WIPACrepo/wuBase-hardware/README.md

# wuBase-hardware
Hardware design files for wuBase photosensor control and readout board developed for IceCube Neutrino Observatory
