WIPACrepo/wuBase-hardware/wuBaseV1.4/wuBaseV1.4PH/wuBaseV1.4PH-3d-view3.png

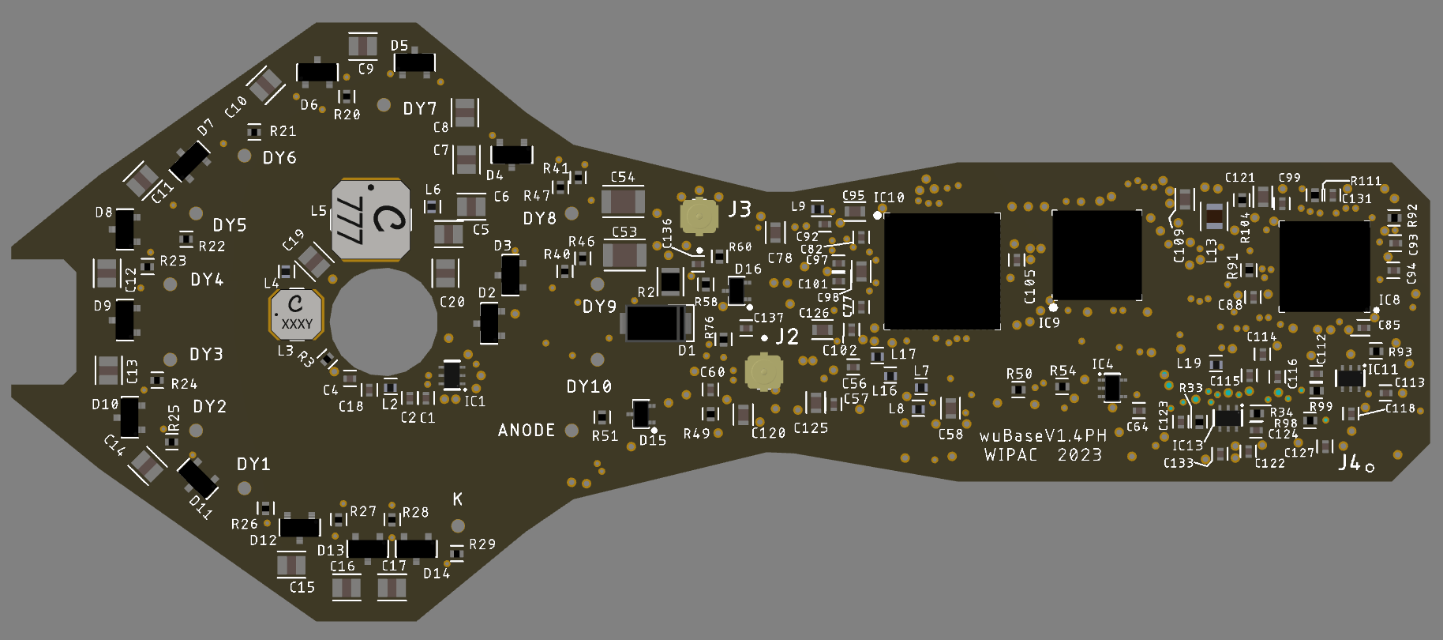
wuBaseV1.4/wuBaseV1.4PH/wuBaseV1.4PH-3d-view3.png
