WIPACrepo/wuBase-hardware/wuBaseV1.4/wuBaseV1.4PH/wuBaseV1.4PH-bom.xlsx

Qty | Value | Package | Parts | Description | MFG | MPN | POPULATE
1 | 0 | R0402 | R108 | Resistor |  | RC0402JR-070RL | 1
4 | 0.01uF | C0402 | C35, C51, C59, C67 | Capacitor |  | CGA2B2X5R1E103K050BA | 1
45 | 0.1uF | C0402 | C2, C3, C4, C34, C50, C56, C60, C61, C64, C69, C71, C73, C85, C87, C88, C90, C91, C92, C93, C94, C96, C97, C99, C100, C101, C102, C103, C104, C105, C106, C107, C108, C110, C114, C115, C116, C118, C122, C127, C129, C131, C132, C133, C136, C137 | Capacitor |  | GCM155R71C104KA55D | 1
2 | 1 | R0402 | R1, R101 | Resistor |  | AC0402FR-071RL | 1
2 | 1.1M | R0402 | R16, R35 | Resistor |  | AC0402FR-071M1L | 1
2 | 1.2K | R0402 | R52, R77 | Resistor |  | AC0402FR-071K2L | 1
4 | 1.8K | R0402 | R67, R71, R81, R86 | Resistor |  | AC0402FR-071K8L | 1
2 | 100 | R0402 | R91, R94 | Resistor |  | AC0402FR-07100RL | 1
5 | 10000pF/500V | C1206 | C49, C52, C53, C54, C55 | Capacitor |  | CGA5L4NP02J103J160AA | 1
1 | 10000uH/LPS6235 | LPS6235 | L5 | Inductor |  | LPS6235-106MRC | 1
8 | 1000pF | C0402 | C1, C57, C62, C70, C72, C74, C86, C89 | Capacitor |  | GCM155R71H102KA37D | 1
1 | 1000uH/LPS4040 | LPS4040 | L3 | Inductor |  | LPS4040-105MRC | 1
4 | 100K | R0402 | R47, R104, R110, R111 | Resistor |  | AC0402FR-07100KL | 1
5 | 100pF | C0402 | C18, C112, C113, C123, C124 | Capacitor |  | C0402C101J3GACAUTO | 1
1 | 10K | R0402 | R95 | Resistor |  | AC0402FR-0710KL | 1
2 | 10M | R0402 | R30, R36 | Resistor |  | AC0402FR-0710ML | 1
1 | 10uF/6.3V | C0805 | C119 | Capacitor |  | C0805C106K8PACTU | 1
1 | 11pF | C0402 | C82 | Capacitor |  | GCM1555C1H110FA16D | 1
8 | 1K | R0402 | R42, R49, R56, R57, R65, R76, R90, R92 | Resistor |  | AC0402FR-071KL | 1
1 | 1M/150V | R0805 | R2 | Resistor |  | AC0805FR-071ML | 1
5 | 1uF | C0603 | C58, C66, C78, C84, C109 | Capacitor |  | LMK107B7105KAHT | 1
2 | 2.2K | R0402 | R80, R89 | Resistor |  | AC0402FR-072K2L | 1
6 | 2.2uF | C0603 | C95, C98, C117, C120, C125, C126 | Capacitor |  | CGA3E1X7R0J225K080AC | 1
2 | 2.4K | R0402 | R83, R87 | Resistor |  | AC0402FR-072K4L | 1
1 | 2.7K | R0402 | R72 | Resistor |  | AC0402FR-072K7L | 1
2 | 200 | R0402 | R55, R59 | Resistor |  | AC0402FR-07200RL | 1
12 | 200M/200V | R1206 | R4, R5, R6, R7, R8, R9, R10, R11, R12, R13, R14, R15 | Resistor |  | CRCW1206200MJPEAHR | 1
2 | 20K | R0402 | R64, R93 | Resistor |  | AC0402FR-0720KL | 1
1 | 20pF | C0402 | C65 | Capacitor |  | GCM1555C1H200JA16D | 1
1 | 22 | R0402 | R53 | Resistor |  | AC0402FR-0722RL | 1
4 | 220 | R0402 | R70, R74, R79, R85 | Resistor |  | AC0402FR-07220RL | 1
39 | 2200pF/250V | C0805 | C5, C6, C7, C8, C9, C10, C11, C12, C13, C14, C15, C16, C17, C21, C22, C23, C24, C25, C26, C27, C28, C29, C30, C31, C32, C33, C36, C37, C38, C39, C40, C41, C42, C43, C44, C45, C46, C47, C48 | Capacitor |  | C0805C222JAGACAUTO | 1
1 | 220pF/100V/5% | C0805 | C20 | Capacitor |  | C0805C221J1GACAUTO | 1
2 | 240 | R0402 | R78, R84 | Resistor |  | AC0402FR-07240RL | 1
4 | 27 | R0402 | R33, R34, R98, R99 | Resistor |  | AC0402FR-0727RL | 1
1 | 270 | R0402 | R54 | Resistor |  | AC0402FR-07270RL | 1
1 | 270K | R0402 | R62 | Resistor |  | AC0402FR-07270KL | 1
2 | 330 | R0402 | R69, R73 | Resistor |  | AC0402FR-07330RL | 1
1 | 33pF | C0402 | C134 | Capacitor |  | GCM1555C1H330FA16D | 1
1 | 3900pF/50V | C0805 | C19 | Capacitor |  | CGA4C2C0G1H392J060AA | 1
17 | 390K | R0402 | R3, R17, R18, R19, R20, R21, R22, R23, R24, R25, R26, R27, R28, R29, R39, R40, R41 | Resistor |  | AC0402FR-07390KL | 1
3 | 3pF | C0402 | C75, C80, C135 | Capacitor |  | GCM1555C1H3R0BA16D | 1
4 | 4.7uF | C0603 | C111, C121, C128, C130 | Capacitor |  | JMK107BJ475KAHT | 1
1 | 430 | R0402 | R75 | Resistor |  | AC0402FR-07430RL | 1
1 | 47K | R0402 | R51 | Resistor |  | AC0402FR-0747KL | 1
4 | 47M/150V | R0805 | R31, R32, R37, R38 | Resistor |  | RC0805JR-0747ML | 1
3 | 49.9 | R0402 | R45, R46, R48 | Resistor |  | AC0402FR-0749R9L | 1
2 | 4pF | C0402 | C79, C83 | Capacitor |  | GCM1555C1H4R0BA16D | 1
1 | 510 | R0402 | R50 | Resistor |  | AC0402FR-07510RL | 1
1 | 56 | R0402 | R60 | Resistor |  | AC0402FR-0756RL | 1
2 | 7.5pF | C0402 | C76, C77 | Capacitor |  | GCQ1555C1H7R5BB01D | 1
2 | 74AUP2G3404GW | SC70-6L | IC11, IC13 | Buffer plus inverter |  | 74AUP2G3404GW,125 | 1
1 | 74LVC1T45DCK | SC70-6L | IC1 | Level Translator |  | 74LVC1T45GW-Q100H | 1
1 | 750 | R0402 | R68 | Resistor |  | AC0402FR-07750RL | 1
2 | 8pF | C0402 | C63, C81 | Capacitor |  | GCM1555C1H8R0BA16D | 1
2 | AD8014ART | SOT23-5 | IC2, IC5 | Amplifier |  | AD8014ARTZ-REEL7 | 1
13 | BAS101S,215 | SOT23 | D2, D3, D4, D5, D6, D7, D8, D9, D10, D11, D12, D13, D14 | High voltage switching diodes |  | BAS101S,215 | 1
2 | BAV99W,115 | SC70-3L | D15, D16 | Dual Schottky Diodes |  | BAV99W,115 | 1
2 | U.FL-R-SMT-1(10) | HIROSE_U.FL-R-SMT-1 | J2, J3 | Coax connector |  | U.FL-R-SMT-1(10) | 1
1 | 3M-45216-220230 | 3M-45216-220230 | J1 | Header | 3M | 45216-220230 | 1
1 | ICE40UP5K-SG48I | QFN48 | IC9 | iCE40 Ultra FPGA SG48 version |  | ICE40UP5K-SG48I | 1
1 | INA199C2DCK | SC70-6L | IC12 | INA199 Low or High-Side Current Shunt Monitor |  | INA199C2DCKR | 1
1 | LTC2141IUP-12 | QFN64 | IC10 | ADC |  | LTC2141IUP-12 | 1
1 | MAX9013EUA | MSOP8 | IC3 | Comparator |  | MAX9013EUA+ | 1
1 | MLZ2012N101LT | L0805 | L13 | Inductor |  | MLZ2012N101LTD25 | 1
9 | MMZ1005A222ETD25 | L0402 | L2, L4, L6, L9, L10, L12, L14, L16, L17 | Chip bead |  | MMZ1005A222ETD25 | 1
7 | MMZ1005S601HTD25 | L0402 | L1, L7, L8, L11, L15, L18, L19 | Chip bead |  | MMZ1005S601ETD25 | 1
1 | SMAJ150A | DO214AC | D1 | TVS Diode, unidirectional |  | SMAJ150A | 1
1 | SN74AUC1G17DCK | SC70-5L | IC4 | Schmitt trigger buffer |  | SN74AUC1G17DCKR | 1
1 | STM32L552CCU | UFQFPN48 | IC8 | ARM Cortex-M33 MCU+FPU |  | STM32L552CCU6 | 1
2 | THS4551IRGT | LFCSP16 | IC6, IC7 | Amplifier |  | THS4551IRGTR | 1
