WIPACrepo/wuBase-hardware/wuBaseV1.4/wuBaseV1.4PH/wuBaseV1.4PH-schematic.pdf

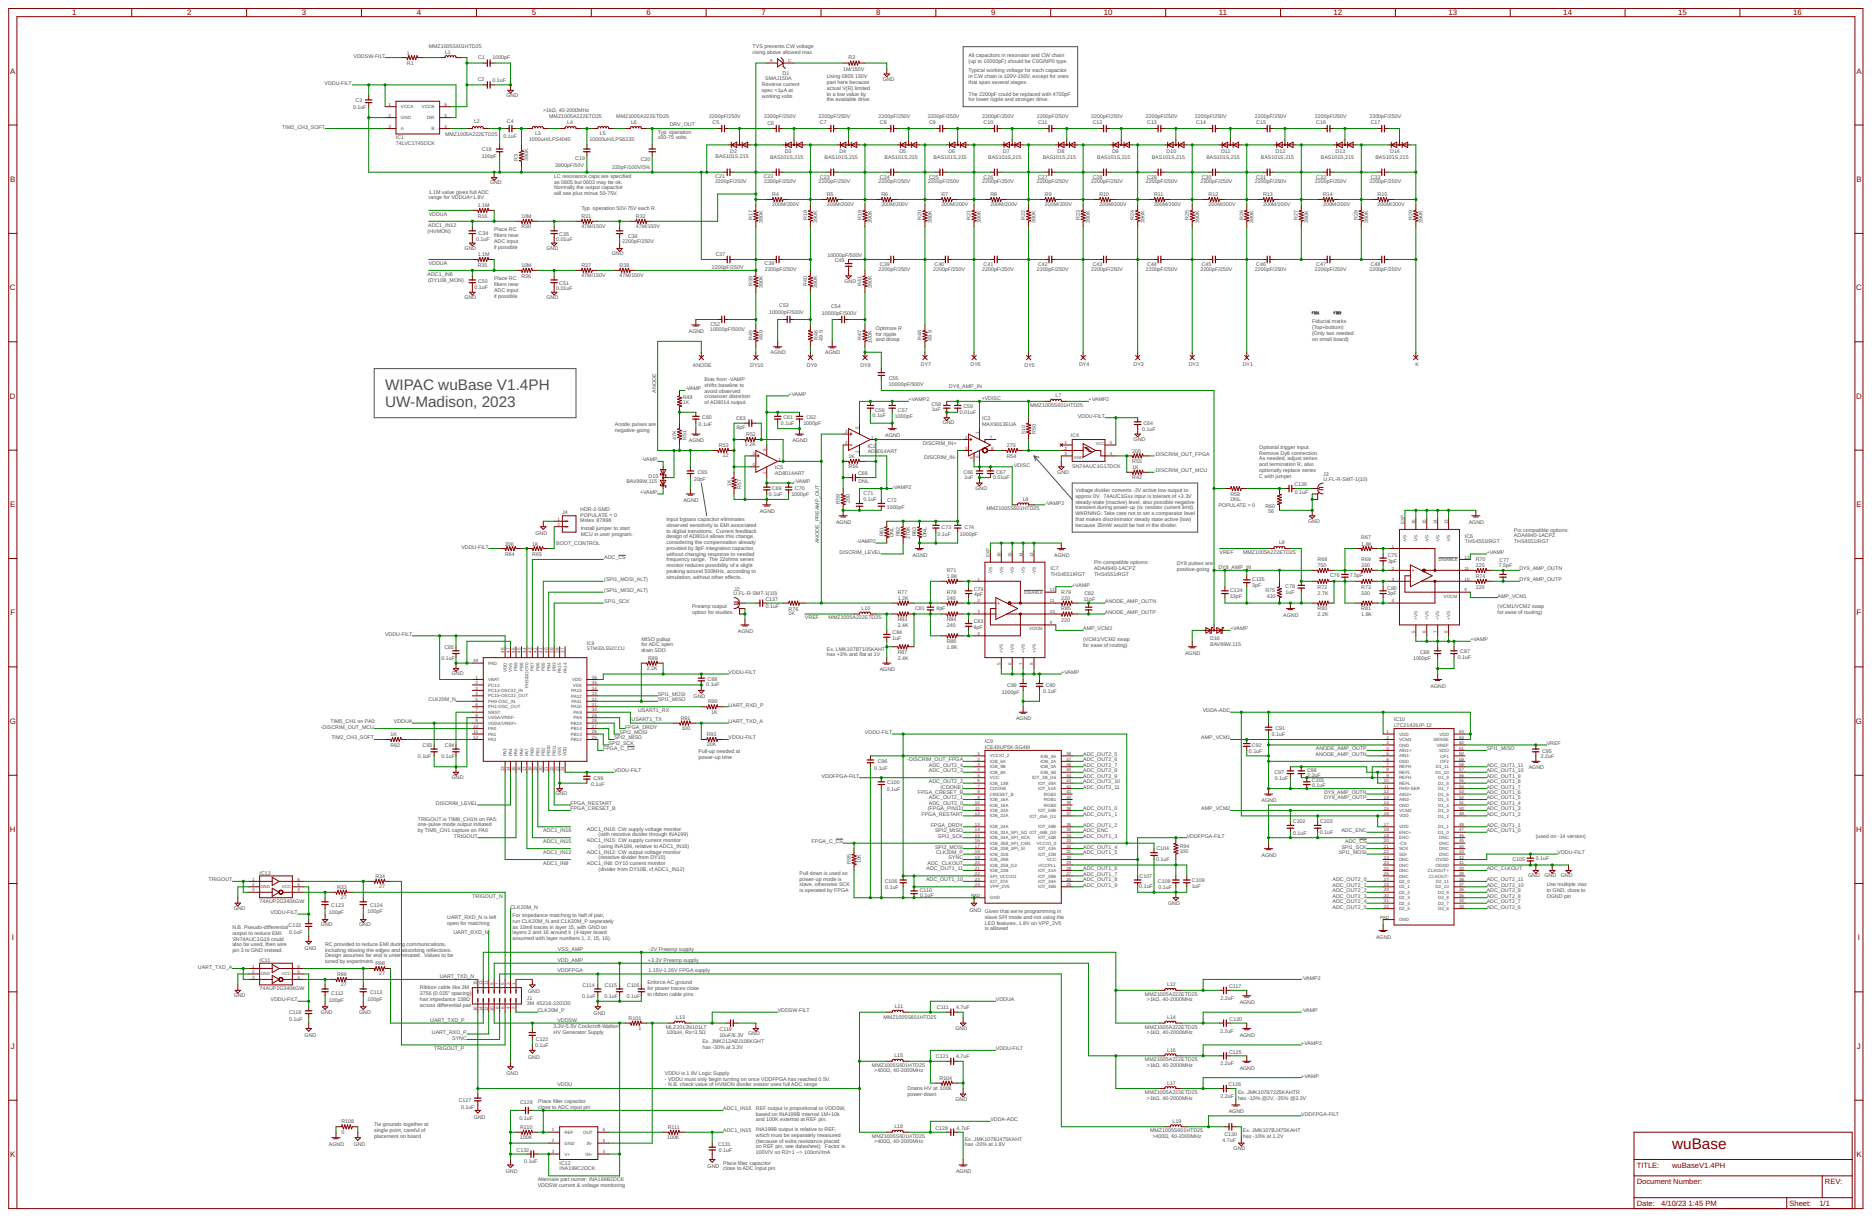
[picture p5: page 1]

TVS prevents CW voltage
rising above allowed max

All capacitors in resonator and CW chain
(up to 10000pF) should be C0G/NP0 type.
Typical working voltage for each capacitor
in CW chain is 100V-150V, except for ones
that span several stages. The 2200pF could be replaced with 4700pF

SMAJ150A
the available drive. Reverse current spec <1µA at working volts

for lower ripple and stronger drive.

LC resonance caps are specified
as 0805 but 0603 may be ok. Normally the output capacitor will see plus minus 50-75V.

1.1M value gives full ADC
range for VDDUA=1.8V

filters near ADC input
if possible

Optional trigger input. Remove Dy8 connection. As needed, adjust series and termination R, also

U.FL-R-SMT-1(10) DNL POPULATE = 0

optionally replace series C with jumper.

Voltage divider converts -2V active low output to
approx 0V. 74AUC1Gxx input is tolerant of +3.3V
steady-state (inactive) level, also possible negative
transient during power-up (w. resistor current limit). WARNING: Take care not to set a comparator level that makes discriminator steady state active (low) because 35mW would be lost in the divider.

HDR-2-SMD Molex 87898 POPULATE = 0 GND

Install jumper to start MCU in user program.

Input bypass capacitor eliminates observed sensitivity to EMI associated
to digital transitions. Current feedback design of AD8014 allows this change, considering the compensation already provided by 8pF integration capacitor, without changing response to needed

frequency range. The 22ohms series
resistor reduces possibility of a slight peaking around 500MHz, according to
simulation, without other effects.

Preamp output option for studies.

Ex. LMK107B7105KAHT
has +3% and flat at 1V

Pull-up needed at power-up time

TRIGOUT is TIM8_CH1N on PA5: one-pulse mode output initiated
by TIM5_CH1 capture on PA0

ADC1_IN16: CW supply voltage monitor
(with resistive divider through INA199) ADC1_IN15: CW supply current monitor
(using INA199, relative to ADC1_IN16) ADC1_IN12: CW output voltage monitor
(resistive divider from DY10) ADC1_IN8: DY10 current monitor
(divider from DY10B, cf ADC1_IN12)

Pull down is used so
power-up mode is
slave, otherwise SCK
is operated by FPGA

GND
Use multiple vias
to GND, close to OGND pin

UART_RXD_N is left open for matching

CLK20M_N
For impedance matching to half of pair, run CLK20M_N and CLK20M_P separately as 10mil traces in layer 15, with GND on

Given that we're programming in
slave SPI mode and not using the
LED features, 1.8V on VPP_2V5
is allowed

N.B. Pseudo-differential output to reduce EMI. SN74AUC1G19 could

layers 2 and 16 around it (4-layer board
assumed with layer numbers 1, 2, 15, 16).

also be used, then wire
pin 3 to GND instead.

RC provided to reduce EMI during communications,
including slowing the edges and absorbing reflections. Design assumes far end is unterminated. Values to be
tuned by experiment.

-2V Preamp supply
+3.3V Preamp supply
1.15V-1.26V FPGA supply
Enforce AC ground
for power traces close
to ribbon cable pins

VDDSW
3.3V-5.5V Cockcroft-Walton HV Generator Supply

VDDU is 1.8V Logic Supply
- VDDU must only begin turning on once VDDFPGA has reached 0.5V. - N.B. check value of HVMON divider esistor uses full ADC range

Place filter capacitor close to ADC input pin

Drains HV at power-down

REF output is proportional to VDDSW, based on INA199B internal 1M+10k and 100K external at REF pin. Place filter capacitor close to ADC input pin
ADC1_IN16

Tie grounds together at single point, careful of placement on board

INA199B output is relative to REF, which must be separately measured
(because of extra resistance placed
on REF pin, see datasheet). Factor is 100V/V so R2=1 --> 100mV/mA

Alternate part numer: INA199B2DCK
VDDSW current & voltage monitoring
