WIPACrepo/wuBase-hardware/wuBaseV1.4/wuBaseV1.4PH/wuBaseV1.4PH.brd

## EAGLE design wuBaseV1.4/wuBaseV1.4PH/wuBaseV1.4PH.brd (2023-04-19)

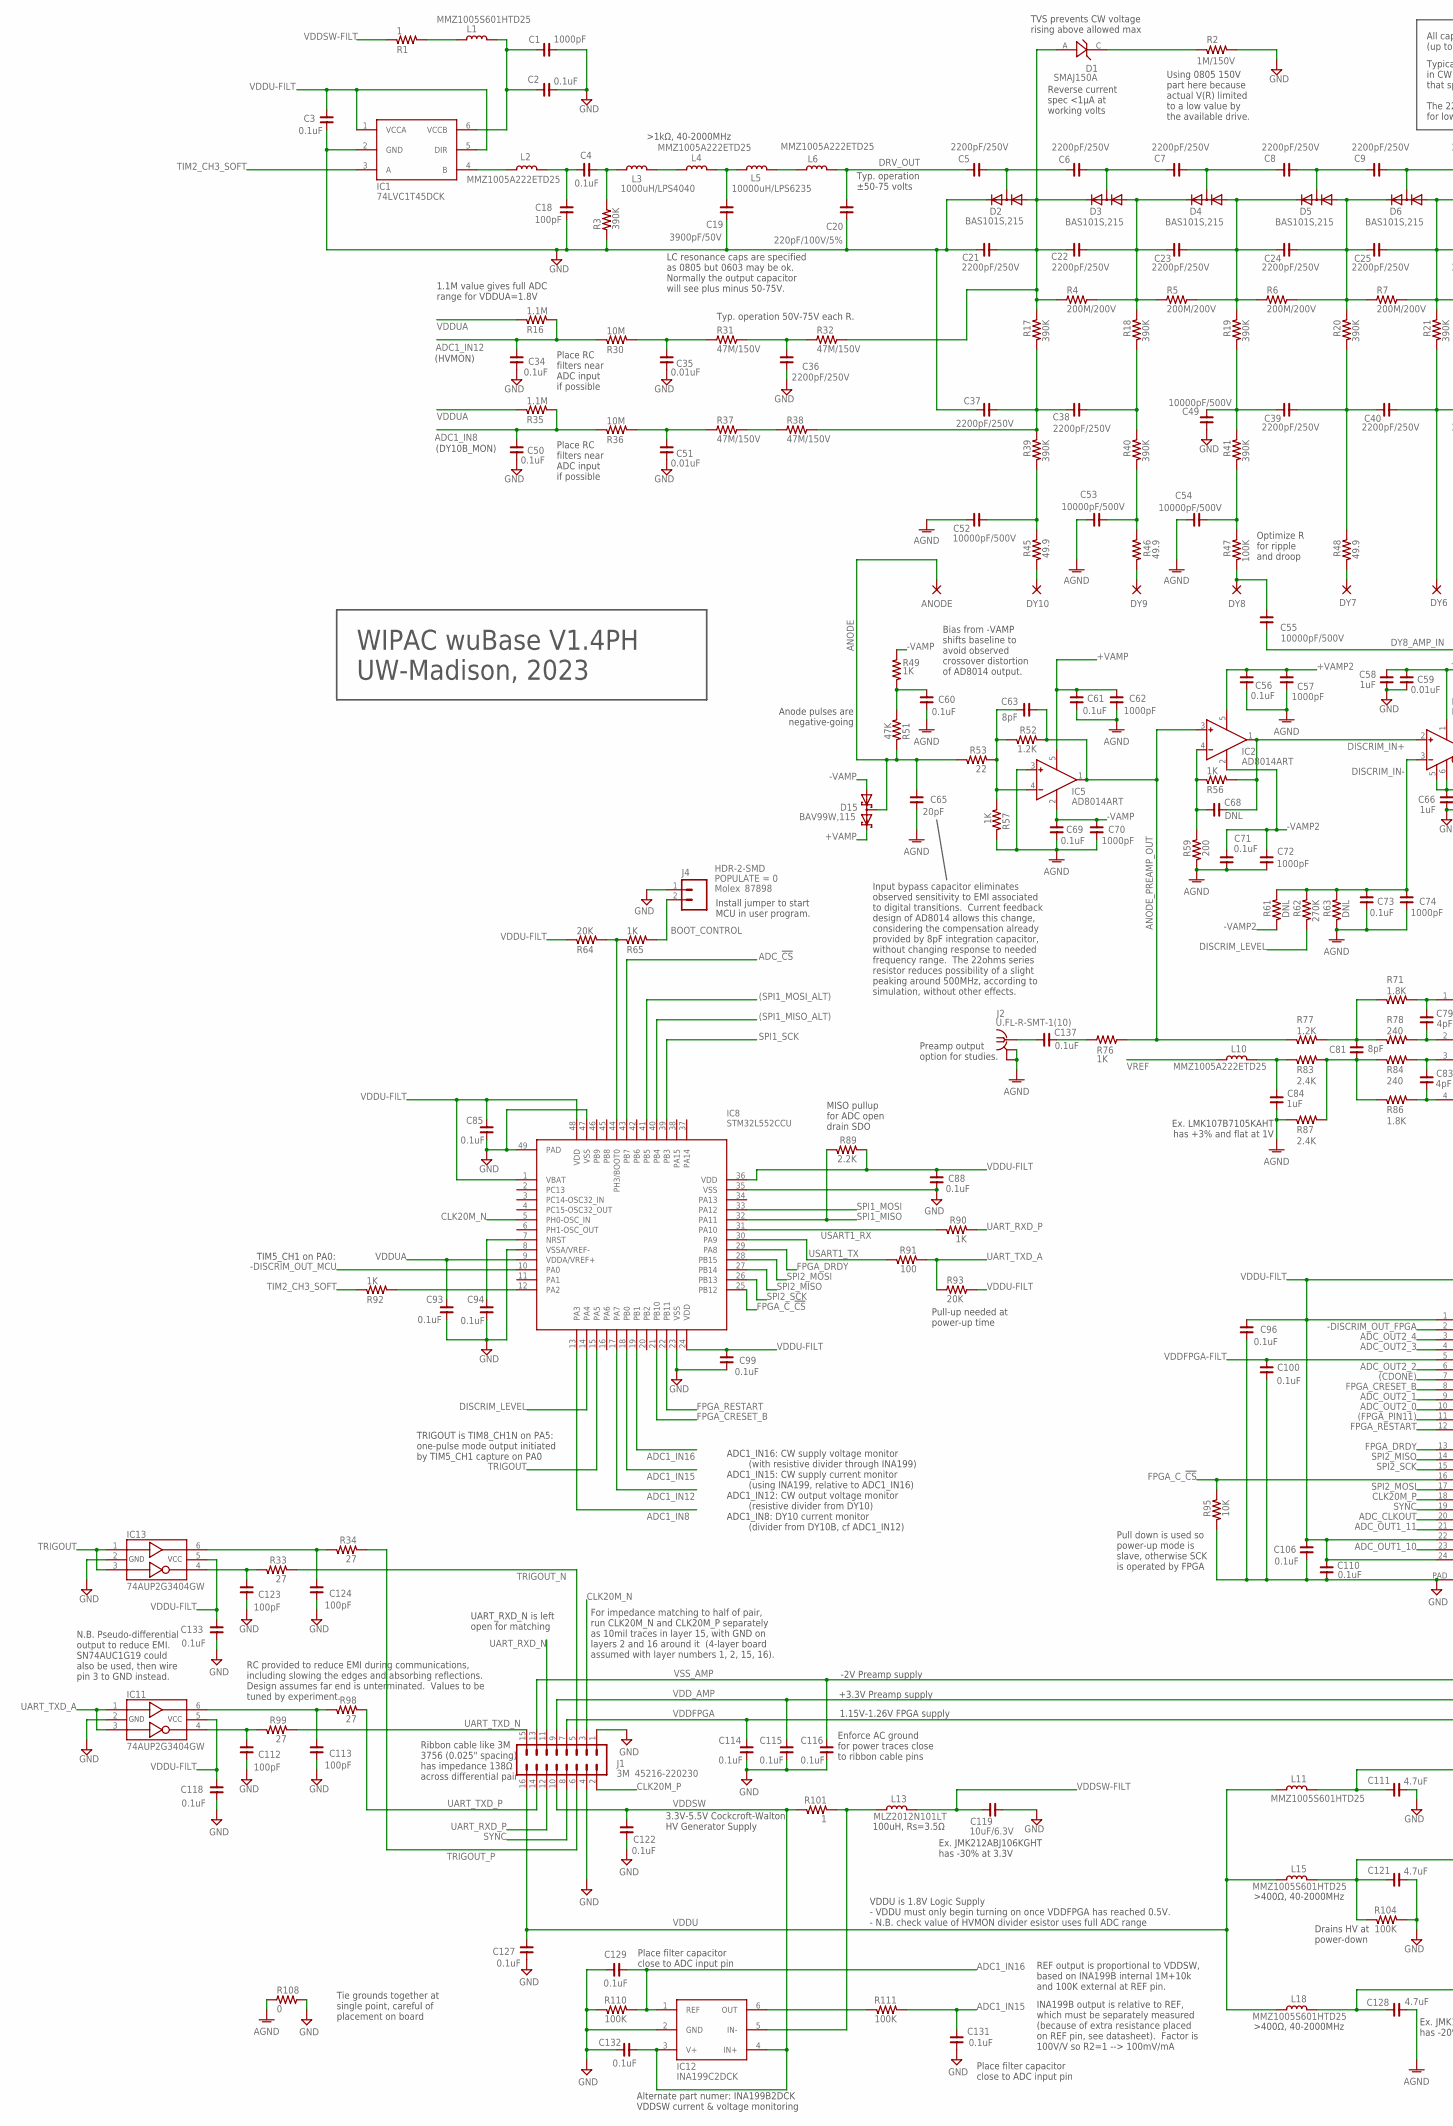
[picture p6: schematic wuBaseV1.4PH.sch, wuBase, part in row 1, column 1]

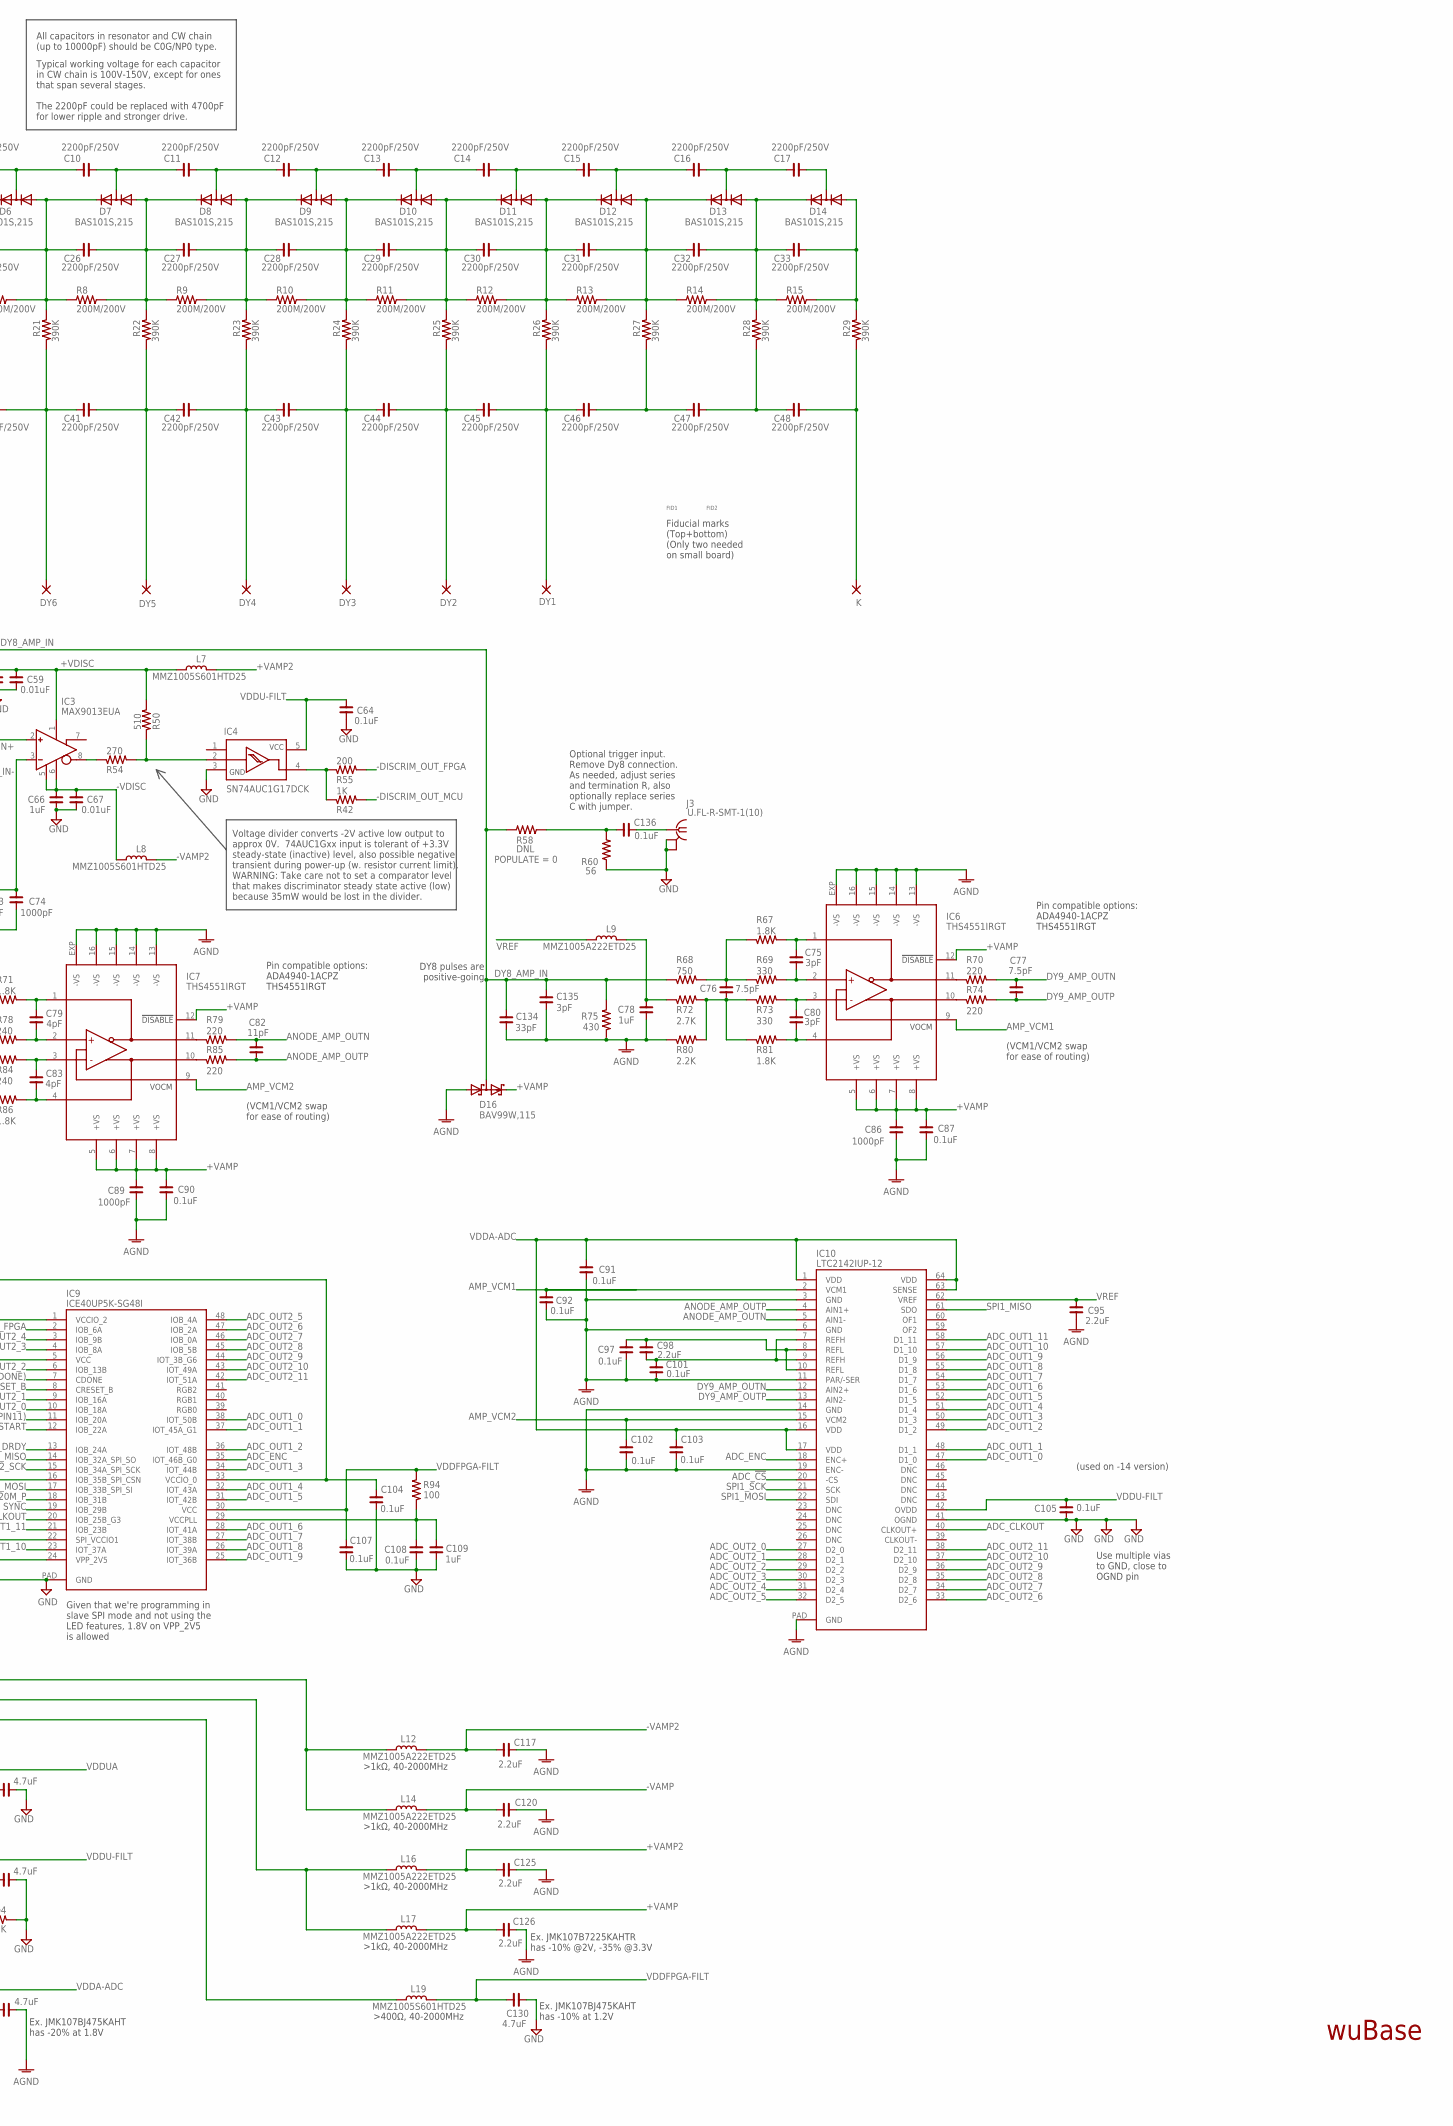
[picture p7: schematic wuBaseV1.4PH.sch, wuBase, part in row 1, column 2]

Parts:
ANODE: PAD-0430-BARE; 0430-BARE
C1, C57, C62, C70, C72, C74, C86, C89: 1000pF; C0402; MPN GCM155R71H102KA37D
C2, C3, C34, C50, C56, C60, C61, C64, C69, C71, C73, C85, C87, C88, C90, C91, C92, C93, C94, C96, C97, C99, C100, C101, C102, C103, C104, C105, C106, C107, C108, C110, C114, C115, C116, C118, C122, C127, C129, C131, C132, C133, C136, C137: 0.1uF; C0402; MPN GCM155R71C104KA55D
C4: 0.1uF; C0402-HV; MPN GCM155R71C104KA55D
C5, C6, C7, C8, C9, C10, C11, C12, C13, C14, C15, C16, C17, C21, C22, C23, C24, C25, C26, C27, C28, C29, C30, C31, C32, C33, C36, C37, C38, C39, C40, C41, C42, C43, C44, C45, C46, C47, C48: 2200pF/250V; C0805-HV; MPN C0805C222JAGACAUTO
C18: 100pF; C0402-HV; MPN C0402C101J3GACAUTO
C19: 3900pF/50V; C0805-HV; MPN CGA4C2C0G1H392J060AA
C20: 220pF/100V/5%; C0805-HV; MPN C0805C221J1GACAUTO
C35, C51, C59, C67: 0.01uF; C0402; MPN CGA2B2X5R1E103K050BA
C49, C52, C53, C54, C55: 10000pF/500V; C1206-HV; MPN CGA5L4NP02J103J160AA
C58, C66, C78, C84, C109: 1uF; C0603; MPN LMK107B7105KAHT
C63, C81: 8pF; C0402; MPN GCM1555C1H8R0BA16D
C65: 20pF; C0402; MPN GCM1555C1H200JA16D
C68: DNL; C0402
C75, C80, C135: 3pF; C0402; MPN GCM1555C1H3R0BA16D
C76, C77: 7.5pF; C0402; MPN GCQ1555C1H7R5BB01D
C79, C83: 4pF; C0402; MPN GCM1555C1H4R0BA16D
C82: 11pF; C0402; MPN GCM1555C1H110FA16D
C95, C98, C117, C120, C125, C126: 2.2uF; C0603; MPN CGA3E1X7R0J225K080AC
C111, C121, C128, C130: 4.7uF; C0603; MPN JMK107BJ475KAHT
C112, C113, C123, C124: 100pF; C0402; MPN C0402C101J3GACAUTO
C119: 10uF/6.3V; C0805; MPN C0805C106K8PACTU
C134: 33pF; C0402; MPN GCM1555C1H330FA16D
D1: SMAJ150A; DO214AC-HV; MPN SMAJ150A
D2, D3, D4, D5, D6, D7, D8, D9, D10, D11, D12, D13, D14: BAS101S,215; SOT23-ROUNDED; MPN BAS101S,215
D15, D16: BAV99W,115; SC70-3L; MPN BAV99W,115
DY1, DY2, DY3, DY4, DY5, DY6, DY7, DY8, DY9, DY10: PAD-0430-BARE; 0430-BARE
FID1, FID2: FIDUCIAL_0.5MM
IC1: 74LVC1T45DCK; SC70-6L-TI; MPN 74LVC1T45GW-Q100H
IC2, IC5: AD8014ART; SOT23-5; MPN AD8014ARTZ-REEL7
IC3: MAX9013EUA; MSOP8; MPN MAX9013EUA+
IC4: SN74AUC1G17DCK; SC70-5L-TI; MPN SN74AUC1G17DCKR
IC6, IC7: THS4551IRGT; LFCSP16; MPN THS4551IRGTR
IC8: STM32L552CCU; UFQFPN48-STMICRO; MPN STM32L552CCU6
IC9: ICE40UP5K-SG48I; QFN48-ICE40ULTRA; MPN ICE40UP5K-SG48I
IC10: LTC2142IUP-12; QFN64-LTC214X; MPN LTC2141IUP-12
IC11, IC13: 74AUP2G3404GW; SC70-6L-TI; MPN 74AUP2G3404GW,125
IC12: INA199C2DCK; SC70-6L-TI; MPN INA199C2DCKR
J1: HDR-16; 3M-45216-220230; MPN 45216-220230
J2, J3: COAX-2GNDU.FL; HIROSE_U.FL-R-SMT-1; MPN U.FL-R-SMT-1(10)
J4: HDR-2-SMD; HEADER-SMD-2X1-MINIMUM; MPN 87898
K: PAD-0430-BARE; 0430-BARE
L1, L7, L8, L11, L15, L18, L19: MMZ1005S601HTD25; L0402; MPN MMZ1005S601ETD25
L2, L4, L6: MMZ1005A222ETD25; L0402-HV; MPN MMZ1005A222ETD25
L3: 1000uH/LPS4040; LPS4040-REDUCED; MPN LPS4040-105MRC
L5: 10000uH/LPS6235; LPS6235-REDUCED; MPN LPS6235-106MRC
L9, L10, L12, L14, L16, L17: MMZ1005A222ETD25; L0402; MPN MMZ1005A222ETD25
L13: MLZ2012N101LT; L0805; MPN MLZ2012N101LTD25
R1, R101: 1; R0402; MPN AC0402FR-071RL
R2: 1M/150V; R0805-HV; MPN AC0805FR-071ML
R3, R17, R18, R19, R20, R21, R22, R23, R24, R25, R26, R27, R28, R29, R39, R40, R41: 390K; R0402-HV; MPN AC0402FR-07390KL
R4, R5, R6, R7, R8, R9, R10, R11, R12, R13, R14, R15: 200M/200V; R1206-HV; MPN CRCW1206200MJPEAHR
R16, R35: 1.1M; R0402; MPN AC0402FR-071M1L
R30, R36: 10M; R0402; MPN AC0402FR-0710ML
R31, R32, R37, R38: 47M/150V; R0805-HV; MPN RC0805JR-0747ML
R33, R34, R98, R99: 27; R0402; MPN AC0402FR-0727RL
R42, R49, R56, R57, R65, R76, R90, R92: 1K; R0402; MPN AC0402FR-071KL
R45, R46, R48: 49.9; R0402-HV; MPN AC0402FR-0749R9L
R47: 100K; R0402-HV; MPN AC0402FR-07100KL
R50: 510; R0402; MPN AC0402FR-07510RL
R51: 47K; R0402; MPN AC0402FR-0747KL
R52, R77: 1.2K; R0402; MPN AC0402FR-071K2L
R53: 22; R0402; MPN AC0402FR-0722RL
R54: 270; R0402; MPN AC0402FR-07270RL
R55, R59: 200; R0402; MPN AC0402FR-07200RL
R58, R61, R63: DNL; R0402
R60: 56; R0402; MPN AC0402FR-0756RL
R62: 270K; R0402; MPN AC0402FR-07270KL
R64, R93: 20K; R0402; MPN AC0402FR-0720KL
R67, R71, R81, R86: 1.8K; R0402; MPN AC0402FR-071K8L
R68: 750; R0402; MPN AC0402FR-07750RL
R69, R73: 330; R0402; MPN AC0402FR-07330RL
R70, R74, R79, R85: 220; R0402; MPN AC0402FR-07220RL
R72: 2.7K; R0402; MPN AC0402FR-072K7L
R75: 430; R0402; MPN AC0402FR-07430RL
R78, R84: 240; R0402; MPN AC0402FR-07240RL
R80, R89: 2.2K; R0402; MPN AC0402FR-072K2L
R83, R87: 2.4K; R0402; MPN AC0402FR-072K4L
R91, R94: 100; R0402; MPN AC0402FR-07100RL
R95: 10K; R0402; MPN AC0402FR-0710KL
R104, R110, R111: 100K; R0402; MPN AC0402FR-07100KL
R108: 0; R0402; MPN RC0402JR-070RL

Connections:
(CDONE): IC9.7 (CDONE)
(FPGA_PIN11): IC9.11 (IOB_20A)
(SPI1_MISO_ALT): IC8.40 (PB4)
(SPI1_MOSI_ALT): IC8.41 (PB5)
+VAMP: C61.1, C62.1, C86.1, C87.1, C89.1, C90.1, C126.2, D15.2 (C2), D16.2 (C2), IC5.5 (V+), IC6.5 (+VS), IC6.6 (+VS), IC6.7 (+VS), IC6.8 (+VS), IC6.12 (!DISABLE), IC7.5 (+VS), IC7.6 (+VS), IC7.7 (+VS), IC7.8 (+VS), IC7.12 (!DISABLE), L17.2
+VAMP2: C56.1, C57.1, C125.2, IC2.5 (V+), L7.2, L16.2
+VDISC: C58.1, C59.1, IC3.1 (VCC), L7.1, R50.2
-DISCRIM_BUFOUT: IC4.4 (OUT), R42.1, R55.1
-DISCRIM_OUT: IC3.8 (QBAR), R54.1
-DISCRIM_OUT_DIVIDER: IC4.2 (IN), R50.1, R54.2
-DISCRIM_OUT_FPGA: IC9.2 (IOB_6A), R55.2
-DISCRIM_OUT_MCU: IC8.10 (PA0), R42.2
-VAMP: C69.1, C70.1, C120.2, D15.1 (A1), IC5.2 (V-), L14.2, R49.1
-VAMP2: C71.1, C72.1, C117.2, IC2.2 (V-), L8.2, L12.2, R61.2
-VDISC: C66.1, C67.1, IC3.5 (LE), IC3.6 (GND), L8.1
ADC1_IN8: C50.1, IC8.13 (PA3), R35.2, R36.1
ADC1_IN12: C34.1, IC8.17 (PA7), R16.2, R30.1
ADC1_IN15: C131.2, IC8.18 (PB0), R111.1
ADC1_IN16: C129.2, IC8.19 (PB1), IC12.1 (REF), R110.1
ADC_!CS: IC8.43 (PB7), IC10.20 (-CS)
ADC_CLKOUT: IC9.20 (IOB_25B_G3), IC10.40 (CLKOUT+)
ADC_ENC: IC9.35 (IOT_46B_G0), IC10.18 (ENC+)
ADC_OUT1_0: IC9.38 (IOT_50B), IC10.47 (D1_0)
ADC_OUT1_1: IC9.37 (IOT_45A_G1), IC10.48 (D1_1)
ADC_OUT1_2: IC9.36 (IOT_48B), IC10.49 (D1_2)
ADC_OUT1_3: IC9.34 (IOT_44B), IC10.50 (D1_3)
ADC_OUT1_4: IC9.32 (IOT_43A), IC10.51 (D1_4)
ADC_OUT1_5: IC9.31 (IOT_42B), IC10.52 (D1_5)
ADC_OUT1_6: IC9.28 (IOT_41A), IC10.53 (D1_6)
ADC_OUT1_7: IC9.27 (IOT_38B), IC10.54 (D1_7)
ADC_OUT1_8: IC9.26 (IOT_39A), IC10.55 (D1_8)
ADC_OUT1_9: IC9.25 (IOT_36B), IC10.56 (D1_9)
ADC_OUT1_10: IC9.23 (IOT_37A), IC10.57 (D1_10)
ADC_OUT1_11: IC9.21 (IOB_23B), IC10.58 (D1_11)
ADC_OUT2_0: IC9.10 (IOB_18A), IC10.27 (D2_0)
ADC_OUT2_1: IC9.9 (IOB_16A), IC10.28 (D2_1)
ADC_OUT2_2: IC9.6 (IOB_13B), IC10.29 (D2_2)
ADC_OUT2_3: IC9.4 (IOB_8A), IC10.30 (D2_3)
ADC_OUT2_4: IC9.3 (IOB_9B), IC10.31 (D2_4)
ADC_OUT2_5: IC9.48 (IOB_4A), IC10.32 (D2_5)
ADC_OUT2_6: IC9.47 (IOB_2A), IC10.33 (D2_6)
ADC_OUT2_7: IC9.46 (IOB_0A), IC10.34 (D2_7)
ADC_OUT2_8: IC9.45 (IOB_5B), IC10.35 (D2_8)
ADC_OUT2_9: IC9.44 (IOT_3B_G6), IC10.36 (D2_9)
ADC_OUT2_10: IC9.43 (IOT_49A), IC10.37 (D2_10)
ADC_OUT2_11: IC9.42 (IOT_51A), IC10.38 (D2_11)
AGND: C52.1, C53.2, C54.2, C56.2, C57.2, C60.2, C61.2, C62.2, C65.2, C69.2, C70.2, C71.2, C72.2, C73.2, C74.2, C78.2, C84.2, C86.2, C87.2, C89.2, C90.2, C91.2, C92.2, C95.2, C97.2, C101.2, C102.2, C103.2, C117.1, C120.1, C125.1, C126.1, C128.1, C134.2, C135.2, D16.1 (A1), IC5.3 (IN+), IC6.13 (-VS), IC6.14 (-VS), IC6.15 (-VS), IC6.16 (-VS), IC6.EXP (-VS), IC7.13 (-VS), IC7.14 (-VS), IC7.15 (-VS), IC7.16 (-VS), IC7.EXP (-VS), IC10.3 (GND), IC10.6 (GND), IC10.11 (PAR/-SER), IC10.14 (GND), IC10.19 (ENC-), IC10.PAD (GND), J2.2 (GND), J2.3 (GND), R57.2, R59.2, R63.2, R75.1, R80.1, R87.1, R108.1
AMP1_INM: C63.1, IC5.4 (IN-), R52.2, R53.1, R57.1
AMP2_INM: C68.1, IC2.4 (IN-), R56.1, R59.1
AMP_VCM1: C92.1, IC6.9 (VOCM), IC10.2 (VCM1)
AMP_VCM2: C102.1, IC7.9 (VOCM), IC10.15 (VCM2)
ANODE: ANODE.P$1, C65.1, D15.3 (C1A2), R51.2, R53.2
ANODE_AMP_OUTN: C82.1, IC10.5 (AIN1-), R79.2
ANODE_AMP_OUTP: C82.2, IC10.4 (AIN1+), R85.2
ANODE_PREAMP_OUT: C63.2, IC2.3 (IN+), IC5.1 (OUT), R52.1, R76.1, R77.1
BIAS_FILT: C60.1, R49.2, R51.1
BOOT0: IC8.44 (PH3/BOOT0), R64.2, R65.1
BOOT_CONTROL: J4.2, R65.2
CH1COAX: C137.1, J2.1 (SIGNAL)
CH1COAX_DC: C137.2, R76.2
CH2COAX: C136.2, J3.1 (SIGNAL)
CH2COAX_DC: C136.1, R58.1, R60.1
CLK20M_N: IC8.5 (PH0-OSC_IN), J1.3
CLK20M_P: IC9.18 (IOB_31B), J1.2
CW_1_KB: C15.2, C16.1, D12.3 (C1A2)
CW_2_1: C14.2, C15.1, D11.3 (C1A2)
CW_3_2: C13.2, C14.1, D10.3 (C1A2)
CW_4_3: C12.2, C13.1, D9.3 (C1A2)
CW_5_4: C11.2, C12.1, D8.3 (C1A2)
CW_6_5: C10.2, C11.1, D7.3 (C1A2)
CW_7_6: C9.2, C10.1, D6.3 (C1A2)
CW_8_7: C8.2, C9.1, D5.3 (C1A2)
CW_9_8: C7.2, C8.1, D4.3 (C1A2)
CW_10_9: C6.2, C7.1, D3.3 (C1A2)
CW_A_10: C5.2, C6.1, D2.3 (C1A2)
CW_KA_K: C17.2, D14.3 (C1A2)
CW_KB_KA: C16.2, C17.1, D13.3 (C1A2)
DISCRIM_IN+: C68.2, IC2.1 (OUT), IC3.2 (IN+), R56.2
DISCRIM_IN-: C73.1, C74.1, IC3.3 (IN-), R61.1, R62.1, R63.1
DISCRIM_LEVEL: IC8.14 (PA4), R62.2
DRV_FILT: C4.2, C18.1, L2.2
DRV_L1INP: C4.1, L3.2, R3.2
DRV_L1OUT: L3.1, L4.1
DRV_L2INP: C19.1, L4.2, L5.2
DRV_L2OUT: L5.1, L6.2
DRV_OUT: C5.1, C20.1, L6.1
DRV_SQUARE: IC1.4 (B), L2.1
DY1: C45.2, C46.1, DY1.P$1, R26.2
DY1A: C30.2, C31.1, D11.1 (A1), D12.2 (C2), R12.2, R13.1, R26.1
DY2: C44.2, C45.1, DY2.P$1, R25.2
DY2A: C29.2, C30.1, D10.1 (A1), D11.2 (C2), R11.2, R12.1, R25.1
DY3: C43.2, C44.1, DY3.P$1, R24.2
DY3A: C28.2, C29.1, D9.1 (A1), D10.2 (C2), R10.2, R11.1, R24.1
DY4: C42.2, C43.1, DY4.P$1, R23.2
DY4A: C27.2, C28.1, D8.1 (A1), D9.2 (C2), R9.2, R10.1, R23.1
DY5: C41.2, C42.1, DY5.P$1, R22.2
DY5A: C26.2, C27.1, D7.1 (A1), D8.2 (C2), R8.2, R9.1, R22.1
DY6: C40.2, C41.1, DY6.P$1, R21.2
DY6A: C25.2, C26.1, D6.1 (A1), D7.2 (C2), R7.2, R8.1, R21.1
DY7: DY7.P$1, R48.2
DY7A: C24.2, C25.1, D5.1 (A1), D6.2 (C2), R6.2, R7.1, R20.1
DY7B: C39.2, C40.1, R20.2, R48.1
DY8: C55.1, DY8.P$1, R47.2
DY8A: C23.2, C24.1, D4.1 (A1), D5.2 (C2), R5.2, R6.1, R19.1
DY8B: C39.1, C49.1, R19.2, R41.1
DY8C: C54.1, R41.2, R47.1
DY8_AMP_IN: C55.2, C134.1, C135.1, D16.3 (C1A2), R58.2, R68.1, R75.2
DY9: DY9.P$1, R46.2
DY9A: C22.2, C23.1, D3.1 (A1), D4.2 (C2), R4.2, R5.1, R18.1
DY9B: C38.2, R18.2, R40.1
DY9C: C53.1, R40.2, R46.1
DY9_AMP_OUTN: C77.1, IC10.12 (AIN2+), R70.2
DY9_AMP_OUTP: C77.2, IC10.13 (AIN2-), R74.2
DY10: DY10.P$1, R45.2
DY10A: C21.2, C22.1, D1.A, D2.1 (A1), D3.2 (C2), R4.1, R17.1, R32.2
DY10B: C37.2, C38.1, R17.2, R38.2, R39.1
DY10B_MON_A: R37.2, R38.1
DY10B_MON_B: C51.1, R36.2, R37.1
DY10C: C52.2, R39.2, R45.1
FPGA_CRESET_B: IC8.21 (PB10), IC9.8 (CRESET_B)
FPGA_C_!CS: IC8.25 (PB12), IC9.16 (IOB_35B_SPI_CSN), R95.1
FPGA_DRDY: IC8.29 (PA8), IC9.13 (IOB_24A)
FPGA_RESTART: IC8.22 (PB11), IC9.12 (IOB_22A)
GND: C1.1, C2.1, C3.1, C18.2, C19.2, C20.2, C21.1, C34.2, C35.2, C36.2, C37.1, C49.2, C50.2, C51.2, C58.2, C59.2, C64.1, C66.2, C67.2, C85.2, C88.2, C93.2, C94.2, C96.2, C99.2, C100.2, C104.2, C105.2, C106.2, C107.2, C108.2, C109.2, C110.2, C111.1, C112.2, C113.2, C114.2, C115.2, C116.2, C118.2, C119.2, C121.1, C122.2, C123.2, C124.2, C127.2, C129.1, C130.2, C131.1, C132.1, C133.2, D2.2 (C2), IC1.2 (GND), IC4.3 (GND), IC8.8 (VSSA/VREF-), IC8.23 (VSS), IC8.35 (VSS), IC8.47 (VSS), IC8.49 (PAD), IC9.PAD (GND), IC10.41 (OGND), IC11.2 (GND), IC12.2 (GND), IC13.2 (GND), J1.1, J1.4, J3.2 (GND), J3.3 (GND), J4.1, R2.1, R3.1, R60.2, R95.2, R104.1, R108.2, R110.2
HVMON_A: C36.1, R31.2, R32.1
HVMON_B: C35.1, R30.2, R31.1
K: C48.2, K.P$1, R29.2
K-DY1-AA: C32.2, C33.1, D13.1 (A1), D14.2 (C2), R14.2, R15.1, R28.1
K-DY1-AB: C47.2, C48.1, R28.2
K-DY1-BA: C31.2, C32.1, D12.1 (A1), D13.2 (C2), R13.2, R14.1, R27.1
K-DY1-BB: C46.2, C47.1, R27.2
KA: C33.2, D14.1 (A1), R15.2, R29.1
unnamed: C79.2, IC7.2 (+IN), R78.2
unnamed: C83.1, IC7.3 (-IN), R84.2
unnamed: C81.2, R83.2, R84.1, R86.1, R87.2
unnamed: C81.1, R71.1, R77.2, R78.1
unnamed: C79.1, IC7.1 (-FB), R71.2
unnamed: C83.2, IC7.4 (+FB), R86.2
unnamed: IC7.11 (-OUT), R79.1
unnamed: IC7.10 (+OUT), R85.1
unnamed: C75.2, IC6.2 (+IN), R69.2
unnamed: C80.1, IC6.3 (-IN), R73.2
unnamed: C76.1, R67.1, R68.2, R69.1
unnamed: C76.2, R72.2, R73.1, R80.2, R81.1
unnamed: C75.1, IC6.1 (-FB), R67.2
unnamed: C80.2, IC6.4 (+FB), R81.2
unnamed: IC6.11 (-OUT), R70.1
unnamed: IC6.10 (+OUT), R74.1
NRST: C94.1, IC8.7 (NRST)
REFH: C98.2, C101.1, IC10.7 (REFH), IC10.9 (REFH)
REFL: C97.1, C98.1, IC10.8 (REFL), IC10.10 (REFL)
SPI1_MISO: IC8.32 (PA11), IC10.61 (SDO), R89.2
SPI1_MOSI: IC8.33 (PA12), IC10.22 (SDI)
SPI1_SCK: IC8.39 (PB3), IC10.21 (SCK)
SPI2_MISO: IC8.27 (PB14), IC9.14 (IOB_32A_SPI_SO)
SPI2_MOSI: IC8.28 (PB15), IC9.17 (IOB_33B_SPI_SI)
SPI2_SCK: IC8.26 (PB13), IC9.15 (IOB_34A_SPI_SCK)
SYNC: IC9.19 (IOB_29B), J1.8
TIM2_CH3: IC8.12 (PA2), R92.2
TIM2_CH3_SOFT: IC1.3 (A), R92.1
TRIGOUT: IC8.15 (PA5), IC13.1 (1A), IC13.3 (2A)
TRIGOUT_N: J1.5, R33.1
TRIGOUT_NA: C123.1, IC13.4 (2Y), R33.2
TRIGOUT_P: J1.6, R34.1
TRIGOUT_PA: C124.1, IC13.6 (1Y), R34.2
TVS_OUT: D1.C, R2.2
UART_RXD_N: J1.11
UART_RXD_P: J1.12, R90.1
UART_TXD_A: IC11.1 (1A), IC11.3 (2A), R91.1, R93.1
UART_TXD_N: J1.15, R99.1
UART_TXD_NA: C112.1, IC11.4 (2Y), R99.2
UART_TXD_P: J1.14, R98.1
UART_TXD_PA: C113.1, IC11.6 (1Y), R98.2
USART1_RX: IC8.31 (PA10), R90.2
USART1_TX: IC8.30 (PA9), R91.2
VCCPLL: C108.1, C109.1, IC9.29 (VCCPLL), R94.2
VDDA-ADC: C91.1, C103.1, C128.2, IC10.1 (VDD), IC10.16 (VDD), IC10.17 (VDD), IC10.63 (SENSE), IC10.64 (VDD), L18.2
VDDFPGA: C114.1, J1.7, L19.1
VDDFPGA-FILT: C100.1, C107.1, C130.1, IC9.5 (VCC), IC9.30 (VCC), L19.2, R94.1
VDDSW: C122.1, C132.2, IC12.3 (V+), IC12.4 (IN+), J1.10, R101.2
VDDSW-FILT: C119.1, L13.2, R1.1
VDDSW-FILT-RL: L1.2, R1.2
VDDSW-FINAL: C1.2, C2.2, IC1.6 (VCCB), L1.1
VDDSW-RL: IC12.5 (IN-), L13.1, R101.1
VDDSW_IMON: IC12.6 (OUT), R111.2
VDDU: C127.1, J1.16, L11.1, L15.1, L18.1
VDDU-FILT: C3.2, C64.2, C85.1, C88.1, C96.1, C99.1, C104.1, C105.1, C106.1, C110.1, C118.1, C121.2, C133.1, IC1.1 (VCCA), IC1.5 (DIR), IC4.5 (VCC), IC8.1 (VBAT), IC8.24 (VDD), IC8.36 (VDD), IC8.48 (VDD), IC9.1 (VCCIO_2), IC9.22 (SPI_VCCIO1), IC9.24 (VPP_2V5), IC9.33 (VCCIO_0), IC10.42 (OVDD), IC11.5 (VCC), IC13.5 (VCC), L15.2, R64.1, R89.1, R93.2, R104.2
VDDUA: C93.1, C111.2, IC8.9 (VDDA/VREF+), L11.2, R16.1, R35.1
VDD_AMP: C115.1, J1.9, L16.1, L17.1
VREF: C95.1, IC10.62 (VREF), L9.1, L10.1
VREF_FILT1: C84.1, L10.2, R83.1
VREF_FILT2: C78.1, L9.2, R72.1
VSS_AMP: C116.1, J1.13, L12.1, L14.1

Notes on the sheet:
Fiducial marks (Top+bottom) (Only two needed on small board)
VDDU is 1.8V Logic Supply - VDDU must only begin turning on once VDDFPGA has reached 0.5V. - N.B. check value of HVMON divider esistor uses full ADC range
3.3V-5.5V Cockcroft-Walton HV Generator Supply
(HVMON)
INA199B output is relative to REF, which must be separately measured (because of extra resistance placed on REF pin, see datasheet). Factor is 100V/V so R2=1 --> 100mV/mA
ADC1_IN16: CW supply voltage monitor (with resistive divider through INA199) ADC1_IN15: CW supply current monitor (using INA199, relative to ADC1_IN16) ADC1_IN12: CW output voltage monitor (resistive divider from DY10) ADC1_IN8: DY10 current monitor (divider from DY10B, cf ADC1_IN12)
REF output is proportional to VDDSW, based on INA199B internal 1M+10k and 100K external at REF pin.
Place filter capacitor close to ADC input pin
Alternate part numer: INA199B2DCK VDDSW current & voltage monitoring
100uH, Rs=3.5Ω
WIPAC wuBase V1.4PH UW-Madison, 2023
TVS prevents CW voltage rising above allowed max
Place RC filters near ADC input if possible
Typ. operation 50V-75V each R.
Typ. operation ±50-75 volts
Drains HV at power-down
Typical working voltage for each capacitor in CW chain is 100V-150V, except for ones that span several stages. The 2200pF could be replaced with 4700pF for lower ripple and stronger drive.
All capacitors in resonator and CW chain (up to 10000pF) should be C0G/NP0 type.
LC resonance caps are specified as 0805 but 0603 may be ok. Normally the output capacitor will see plus minus 50-75V.
RC provided to reduce EMI during communications, including slowing the edges and absorbing reflections. Design assumes far end is unterminated. Values to be tuned by experiment.
Using 0805 150V part here because actual V(R) limited to a low value by the available drive.
Reverse current spec <1µA at working volts
Install jumper to start MCU in user program.
1.1M value gives full ADC range for VDDUA=1.8V
1.15V-1.26V FPGA supply
Given that we're programming in slave SPI mode and not using the LED features, 1.8V on VPP_2V5 is allowed
+3.3V Preamp supply
-2V Preamp supply
Optimize R for ripple and droop
Tie grounds together at single point, careful of placement on board
Voltage divider converts -2V active low output to approx 0V. 74AUC1Gxx input is tolerant of +3.3V steady-state (inactive) level, also possible negative transient during power-up (w. resistor current limit). WARNING: Take care not to set a comparator level that makes discriminator steady state activ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
Enforce AC ground for power traces close to ribbon cable pins
N.B. Pseudo-differential output to reduce EMI. SN74AUC1G19 could also be used, then wire pin 3 to GND instead.
MISO pullup for ADC open drain SDO
(DY10B_MON)
DY8 pulses are positive-going
Anode pulses are negative-going
Ex. JMK107BJ475KAHT has -10% at 1.2V
Ex. JMK107BJ475KAHT has -20% at 1.8V
Ex. JMK107B7225KAHTR has -10% @2V, -35% @3.3V
Ex. JMK212ABJ106KGHT has -30% at 3.3V
Ex. LMK107B7105KAHT has +3% and flat at 1V
Pin compatible options: ADA4940-1ACPZ THS4551IRGT
wuBase
Ribbon cable like 3M 3756 (0.025" spacing) has impedance 138Ω across differential pair
Bias from -VAMP shifts baseline to avoid observed crossover distortion of AD8014 output.
Input bypass capacitor eliminates observed sensitivity to EMI associated to digital transitions. Current feedback design of AD8014 allows this change, considering the compensation already provided by 8pF integration capacitor, without changing response to needed frequency range. The 22ohms series r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
Optional trigger input. Remove Dy8 connection. As needed, adjust series and termination R, also optionally replace series C with jumper.
Preamp output option for studies.
Use multiple vias to GND, close to OGND pin
(used on -14 version)
Pull-up needed at power-up time
(VCM1/VCM2 swap for ease of routing)
UART_RXD_N is left open for matching
Pull down is used so power-up mode is slave, otherwise SCK is operated by FPGA
For impedance matching to half of pair, run CLK20M_N and CLK20M_P separately as 10mil traces in layer 15, with GND on layers 2 and 16 around it (4-layer board assumed with layer numbers 1, 2, 15, 16).
TIM5_CH1 on PA0:
TRIGOUT is TIM8_CH1N on PA5: one-pulse mode output initiated by TIM5_CH1 capture on PA0

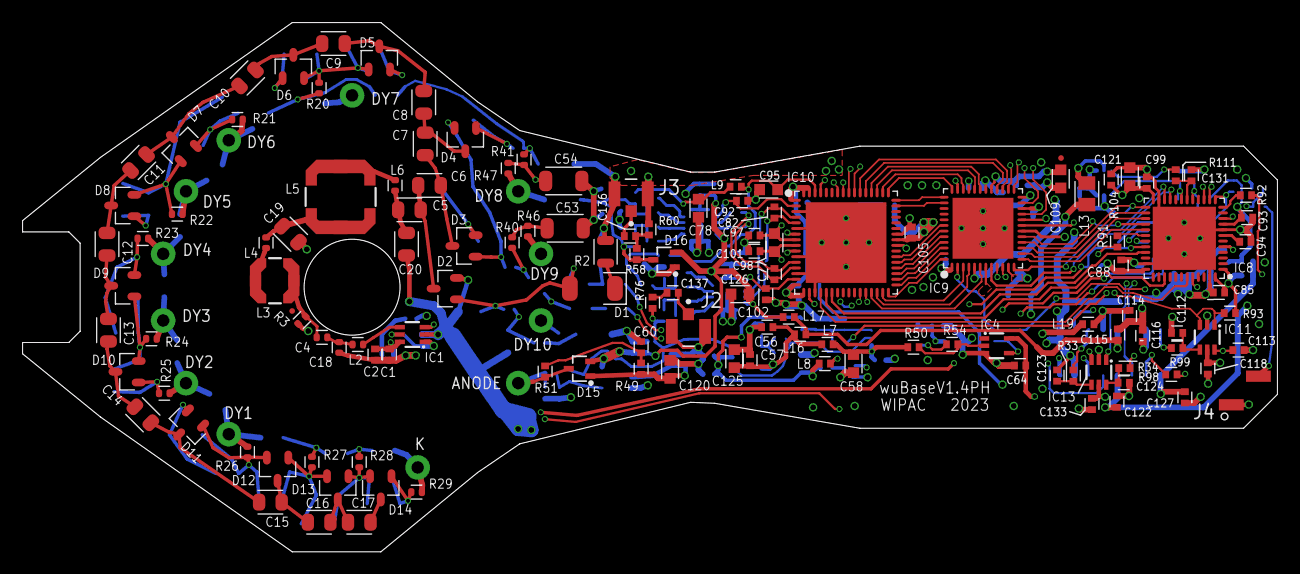
[picture p8: board wuBaseV1.4PH.brd from above]

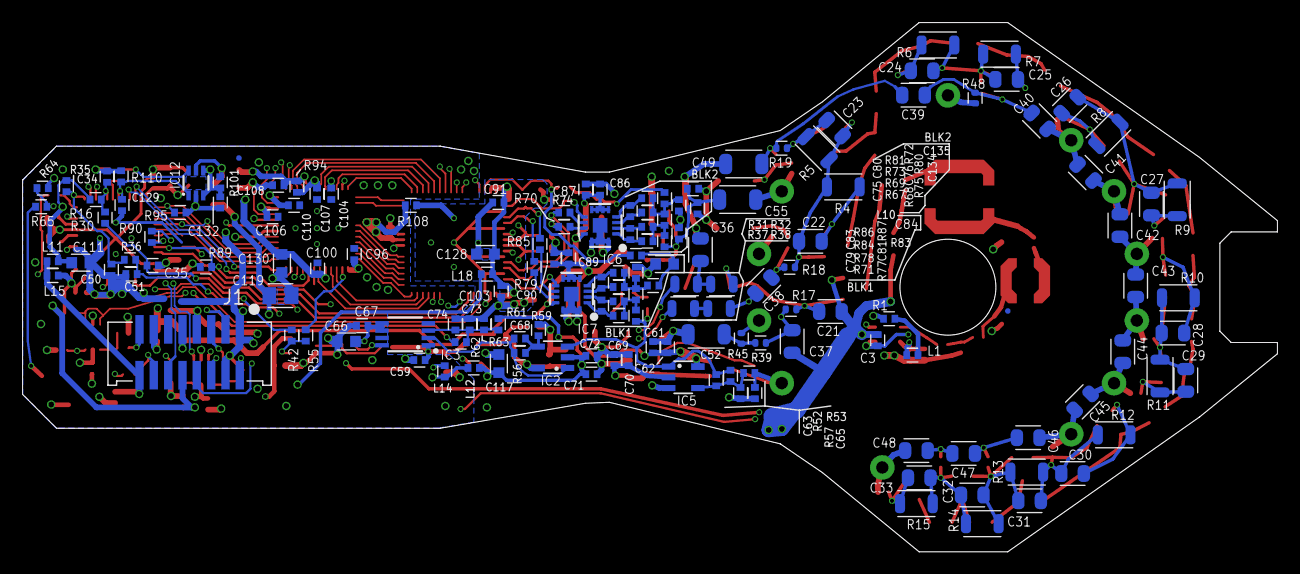
[picture p9: board wuBaseV1.4PH.brd from below]

Board: 4 copper layers, 111.2 x 46.9 mm, 300 parts (168 on the bottom side), 188 nets.
